dadecoza/arduino-mpf1-vdp/Images/GAL20V8.PNG

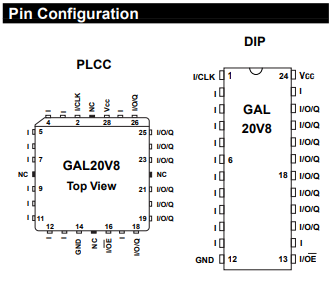
Images/GAL20V8.PNG
