dadecoza/arduino-mpf1-vdp/Images/MPF1_VDP_Proto.jpg

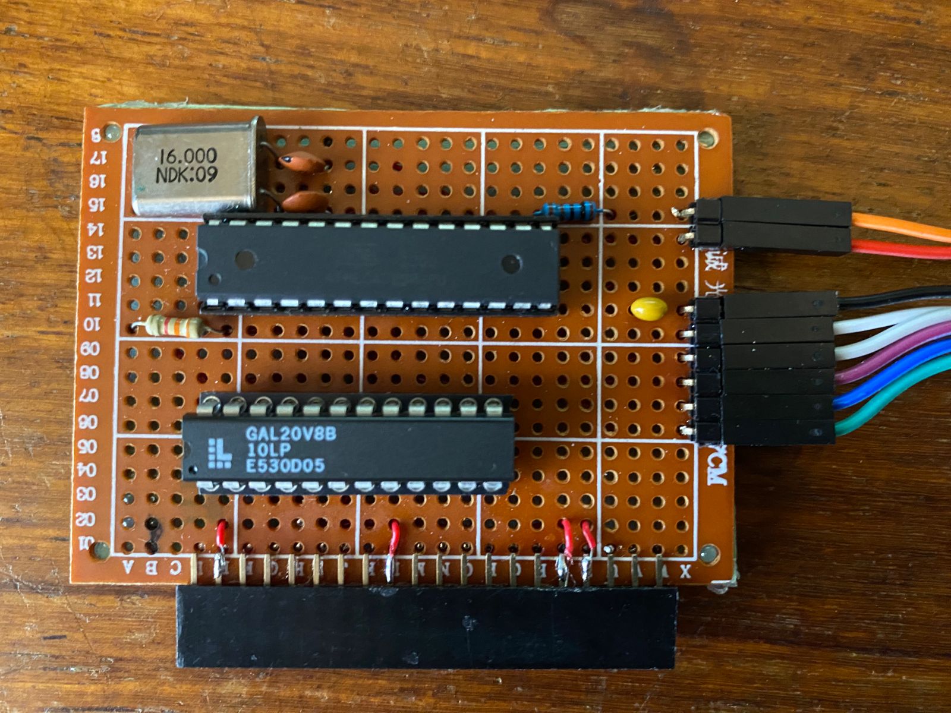
Images/MPF1_VDP_Proto.jpg
