dadecoza/arduino-mpf1-vdp/(commit log)

2023-05-05 added ground, highlited pins of interest
2023-05-12 fixed ground
